ttosi/moodbeam/hardware/README.md

### Schematics, parts and assembly.

#### Parts list
* Ardunion Nano ATMega328 5v
* ESP8266 ESP-01 Serial Wifi Wireless Transceiver
* 4 Channel Bi-Directional Logic Level Converter
* Pololu Step-Down Voltage Regulator D15V35F5S3
* 0.1" 2x4 crimp connector housing
* Some female crimp pins
* ~2 feet of 3/4 acrylic rod
