ttosi/moodbeam/models/README.md

The .stl files for printing the rod end-holders and case.
