ttosi/moodbeam/hardware/front_view.jpg

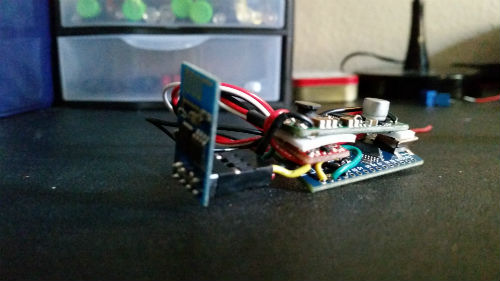
hardware/front_view.jpg
