ttosi/moodbeam/hardware/moodbeam-schematic.png

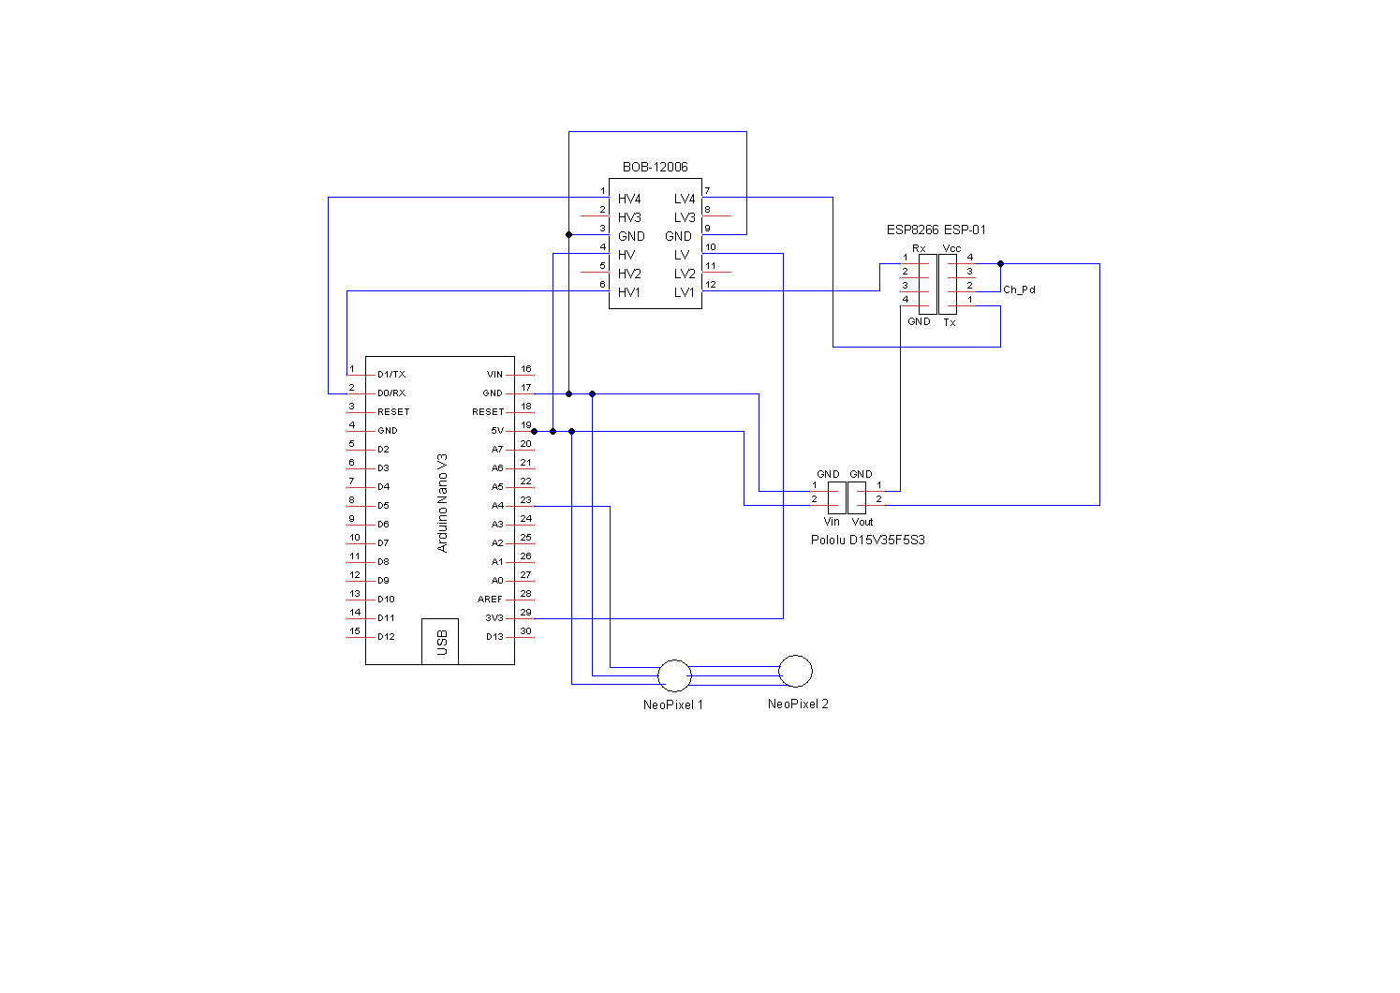
hardware/moodbeam-schematic.png
