ttosi/moodbeam/hardware/side_view.jpg

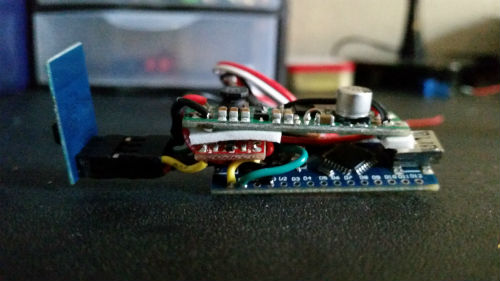
hardware/side_view.jpg
