ttosi/moodbeam/hardware/top_view.jpg

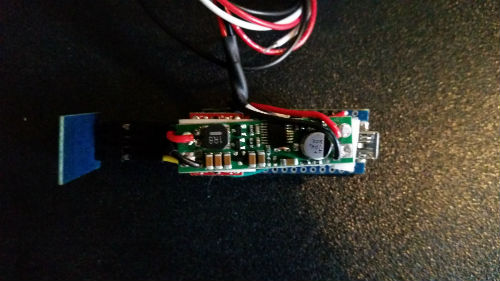
hardware/top_view.jpg
