ttosi/moodbeam/models/moodbeam_case_v3.png

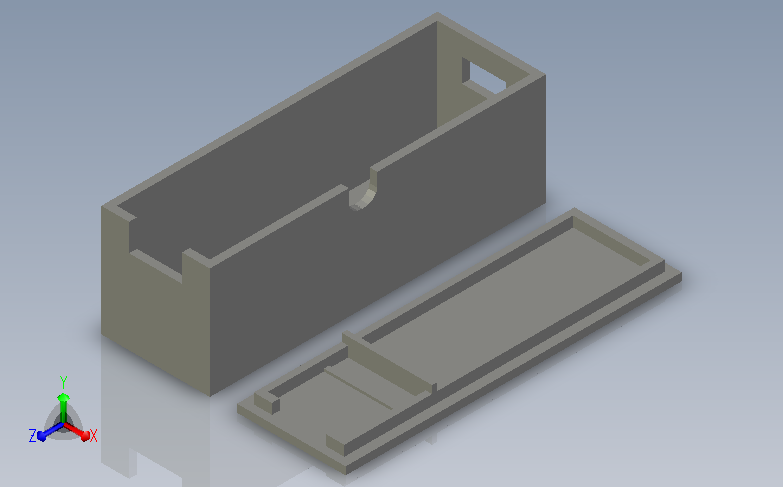
models/moodbeam_case_v3.png
