ttosi/moodbeam/models/moodbeam_rod_holder_v5.png

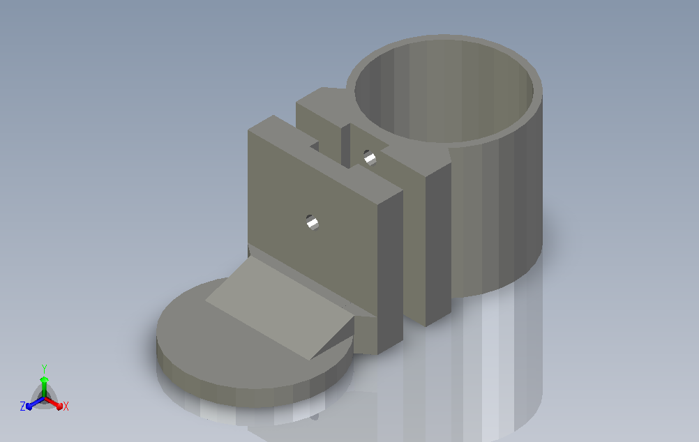
models/moodbeam_rod_holder_v5.png
