ttosi/moodbeam/models/moodbeam_rod_holder.stl

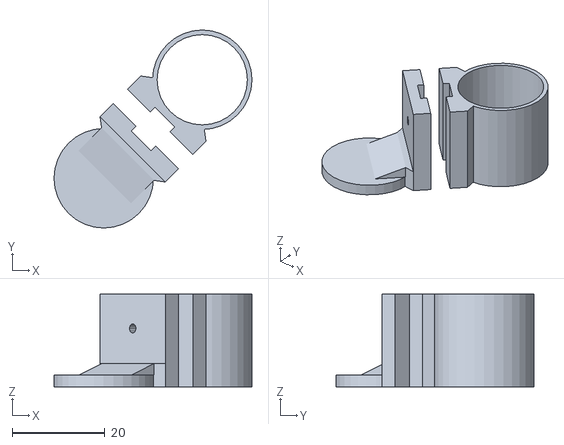
[picture p9: CAD file, 2015-02-18]
models/moodbeam_rod_holder.stl
42.8 x 42.8 x 20.0
