ttosi/moodbeam/models/moodbeam_case_v3.stl

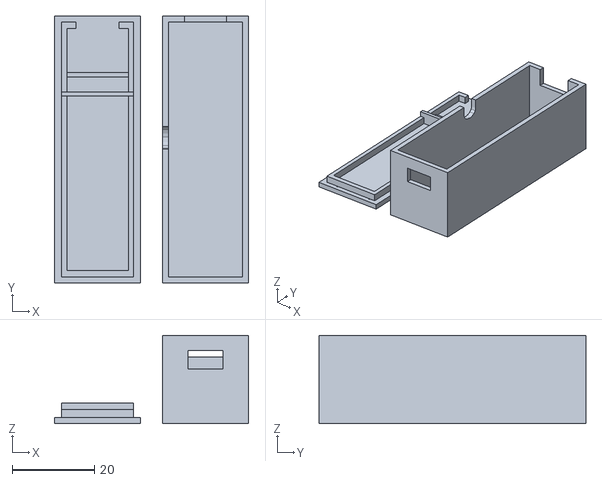
[picture p10: CAD file, 2015-02-18]
models/moodbeam_case_v3.stl
47.3 x 65.0 x 21.5
