ttosi/moodbeam/(list of files, drawings)

Other design files:
hardware/moodbeam-schematic.dsn
