ttosi/moodbeam/hardware/moodbeam_v5.brd

## EAGLE design hardware/moodbeam_v5.brd (2015-05-13)

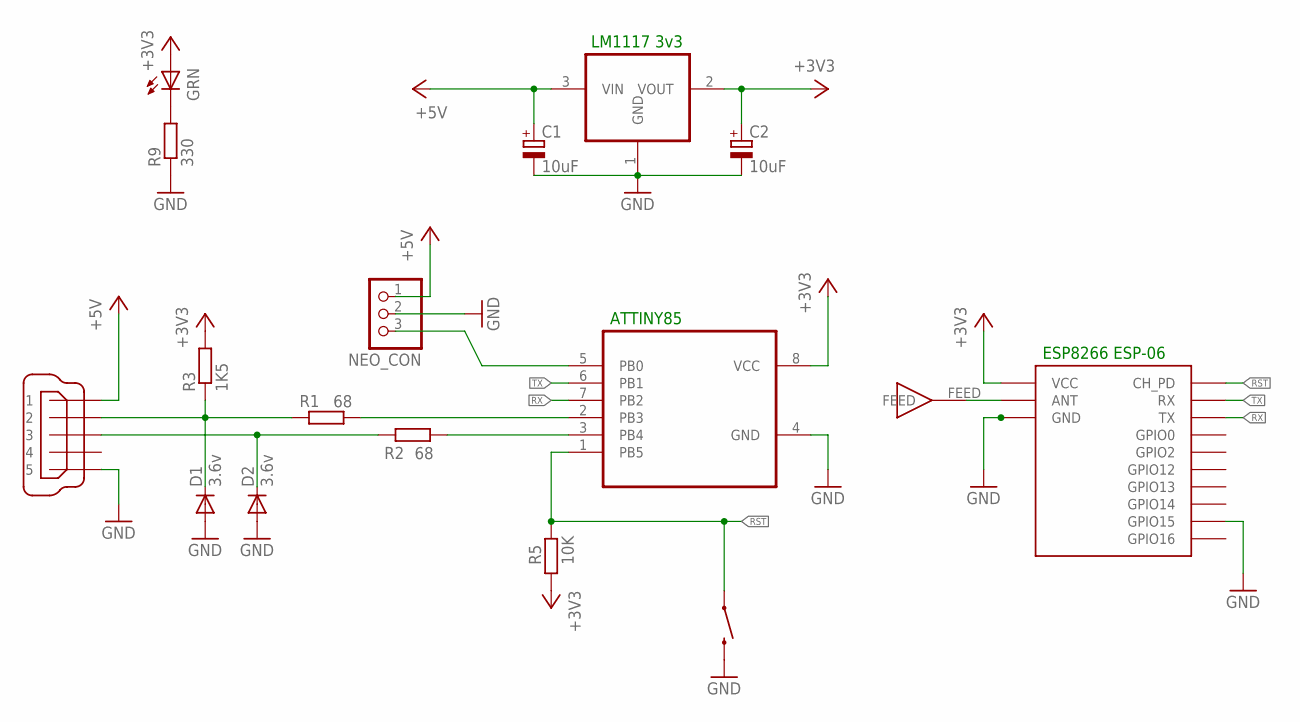
[picture p11: schematic moodbeam_v5.sch]

Parts:
C1, C2: 10uF; R/2012-12R
D1, D2: 3.6v; DO-214AC
IC1: REG1117; SOT223; MPN LM1117 3v3
JP1: NEO_CON; 1X03
LED1: GRN; CHIP-LED0805
R1, R2: 68; R0805
R3: 1K5; R0805
R5: 10K; R0805
R9: 330; R0805
S1: SWITCH-MOMENTARY-2SMD-1101NE; TACTILE-SWITCH-1101NE
U1: ATTINY85-20SU; SOIC127P798X216-8N
U$1: ESP06
U$2: ANT; ANTENNA-CERAMIC
X1: MINI-USB-32005-201; 32005-201

Connections:
+3V3: C2.+, IC1.2 (VOUT), LED1.A, R3.2, R5.1, U1.8 (VCC), U$1.VCC
+5V: C1.+, IC1.3 (VIN), JP1.1, X1.1
GND: C1.-, C2.-, D1.A, D2.A, IC1.1 (GND), JP1.2, R9.1, S1.2, U1.4 (GND), U$1.GND, U$1.GND1 (GND2), U$1.GND2 (GND3), U$1.GND3 (GND4), U$1.GND4 (GND5), U$1.GND5 (GND6), U$1.GND6 (GND7), U$1.GND7 (GND8), U$1.GPIO15, X1.5
unnamed: D1.C, R1.2, R3.1, X1.2
unnamed: R1.1, U1.2 (PB3)
unnamed: D2.C, R2.2, X1.3
unnamed: R2.1, U1.3 (PB4)
unnamed: U$1.ANT, U$2.FEED
unnamed: JP1.3, U1.5 (PB0)
unnamed: LED1.C, R9.2
RST: R5.2, S1.1, U1.1 (PB5), U$1.CH_PD
RX: U1.7 (PB2), U$1.TX
TX: U1.6 (PB1), U$1.RX

Notes on the sheet:
ATTINY85
LM1117 3v3
ESP8266 ESP-06

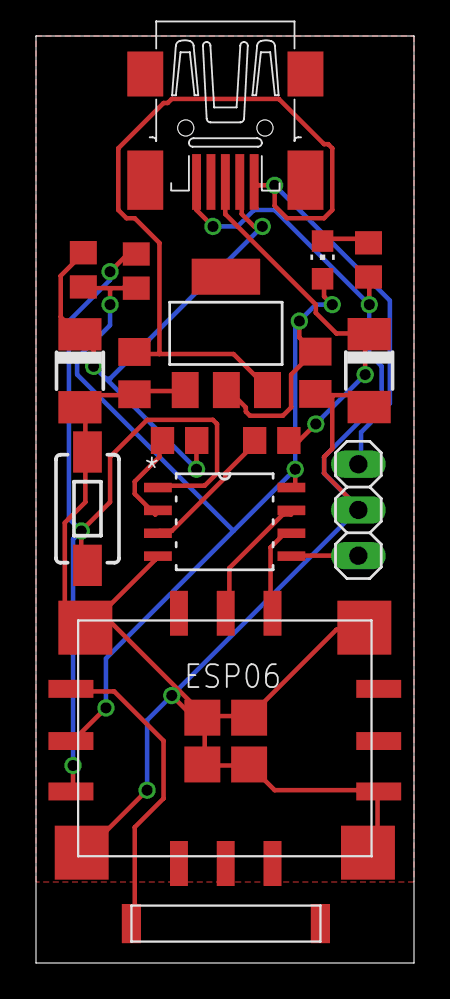
[picture p12: board moodbeam_v5.brd from above]

Board: 2 copper layers, 21.0 x 51.5 mm, 17 parts (0 on the bottom side), 13 nets.
