ttosi/moodbeam/(commit log)

2015-02-18 Added arduino code
2015-02-18 Adding models
    [moodbeam_rod_holder.stl, moodbeams_case_v3.stl]
2015-02-18 Removed console print debugging
2015-02-19 Add schematics
    [moodbeams-schematic.dsn]
2015-02-19 Move schematics to hardware folder
    [moodbeams-schematic.dsn]
2015-02-19 Fixing deleted files
    [moodbeam_rod_holder.stl, moodbeams-schematic.dsn, moodbeams_case_v3.stl]
2015-02-19 Fixing again
    [moodbeam_rod_holder.stl, moodbeams-schematic.dsn, moodbeams_case_v3.stl]
2015-02-19 Updated schematic png
    [moodbeams-schematic.dsn]
2015-03-08 Change moodbeams -> moodbeam
    [moodbeam_case_v3.stl]
2015-03-12 Update arduino protocol
2015-03-15 Stable arduino code
2015-05-13 Add updated schematic and board
    [moodbeam_v5.brd, moodbeam_v5.sch]
